kasshyap123/smart-robo/cad/rev_i_baseline/Rover_RevI_Assembly.step

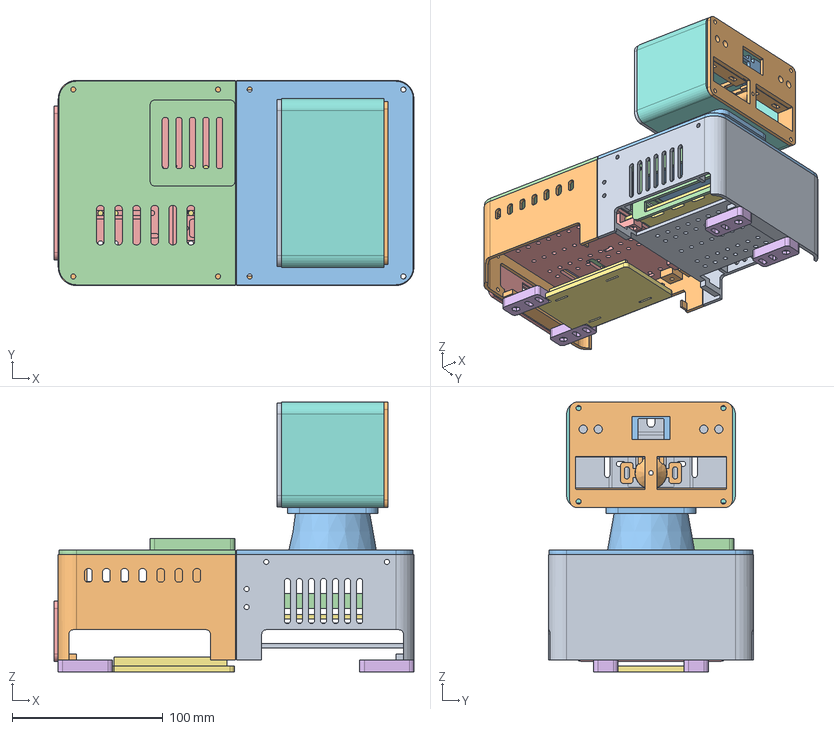
[picture p1: CAD file, 2026-10-26]
cad/rev_i_baseline/Rover_RevI_Assembly.step
238.8 x 136.0 x 179.0 mm
