kasshyap123/smart-robo/website/source-cad/rover_revF_CORRECTED_HOLD/cad/Rover_RevF_HOLD_Assembly.step

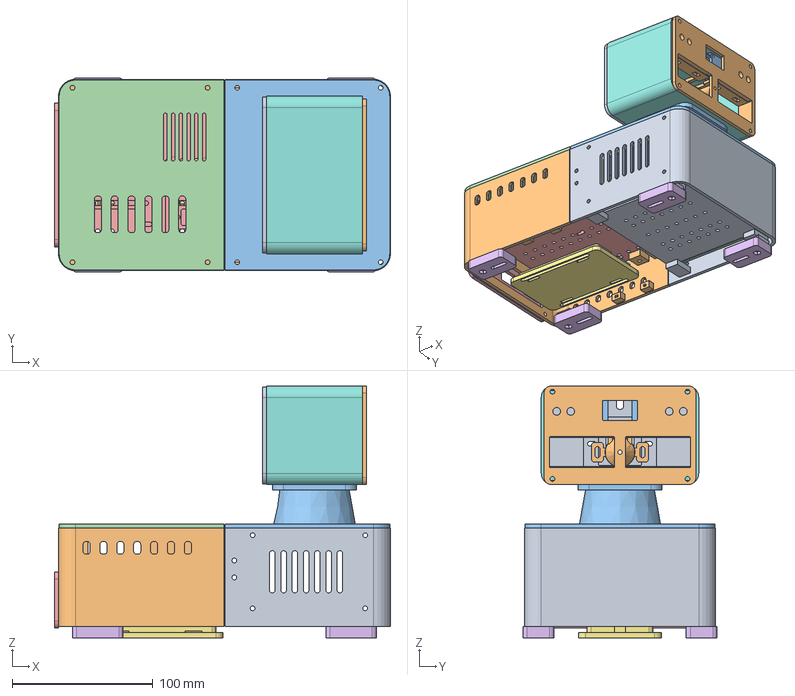
[picture p2: CAD file, 2026-10-26]
website/source-cad/rover_revF_CORRECTED_HOLD/cad/Rover_RevF_HOLD_Assembly.step
238.8 x 138.0 x 179.0 mm
