kasshyap123/smart-robo/cad/current_print_files/16_B13_2.stl

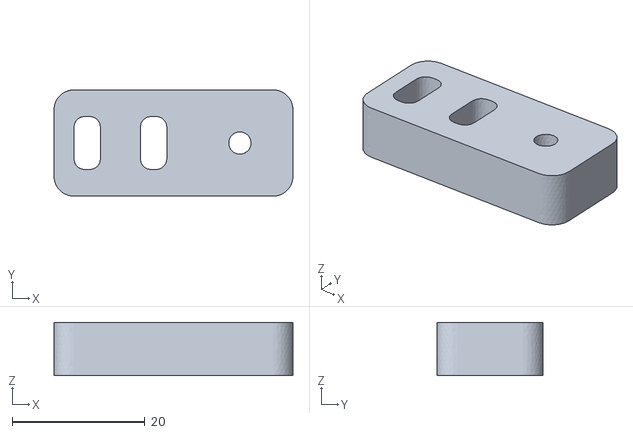
[picture p3: CAD file, 2026-10-26]
cad/current_print_files/16_B13_2.stl
36.0 x 16.0 x 8.00
