kasshyap123/smart-robo/cad/rev_i_baseline/master_step/B10R.step

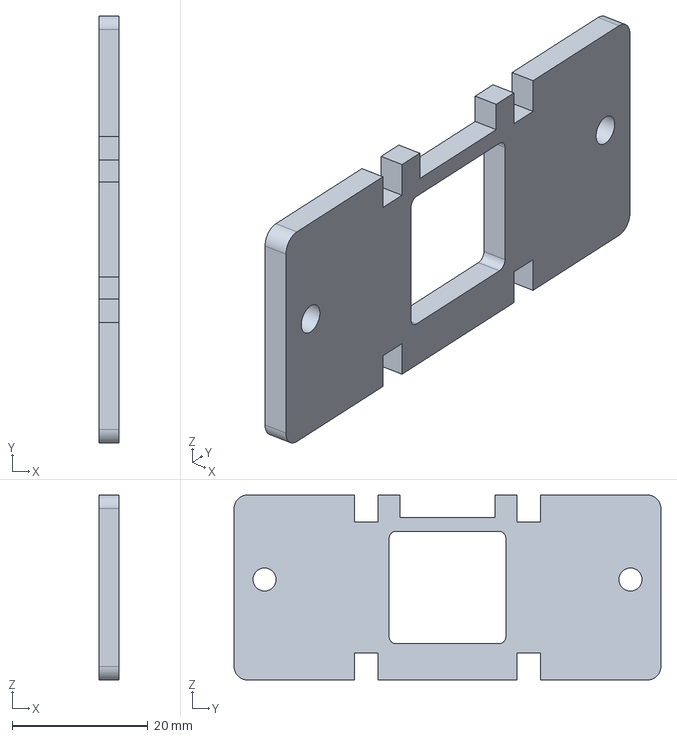
[picture p4: CAD file, 2026-10-26]
cad/rev_i_baseline/master_step/B10R.step
3.00 x 63.0 x 27.3 mm
