kasshyap123/smart-robo/cad/rev_i_baseline/positioned_step/B09.step

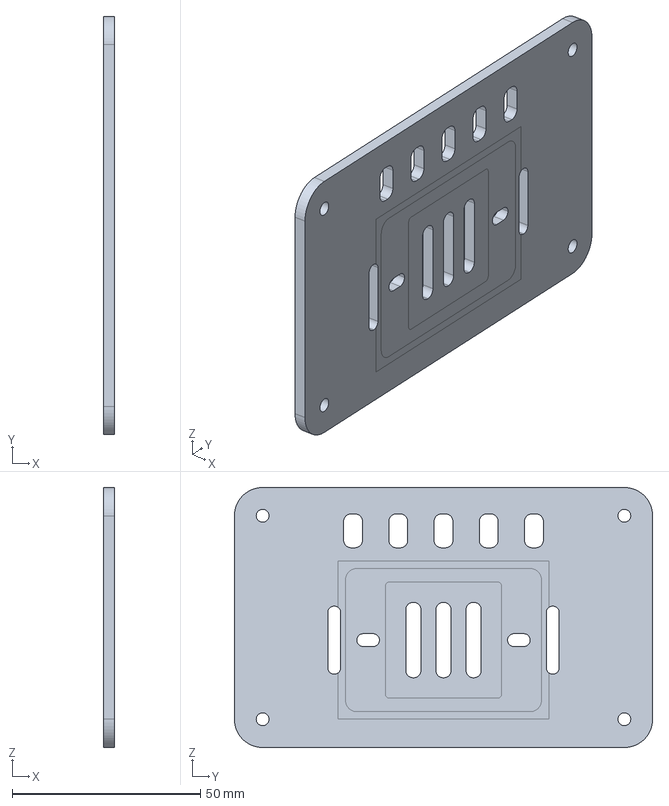
[picture p5: CAD file, 2026-10-26]
cad/rev_i_baseline/positioned_step/B09.step
3.00 x 111.0 x 69.0 mm
