kasshyap123/smart-robo/cad/rev_i_baseline/PRINT_ALL/14_B12.stl

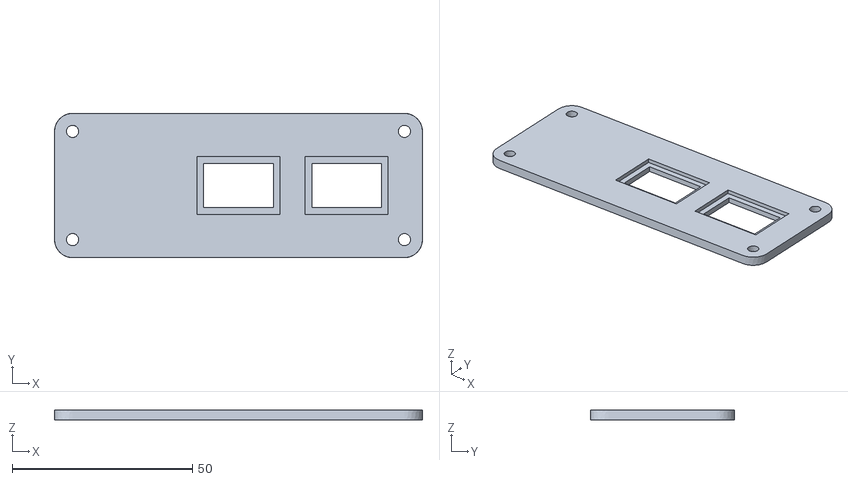
[picture p6: CAD file, 2026-10-26]
cad/rev_i_baseline/PRINT_ALL/14_B12.stl
102.0 x 40.0 x 2.80
