kasshyap123/smart-robo/website/source-cad/rover_revF_CORRECTED_HOLD/final_step/B01_final.step

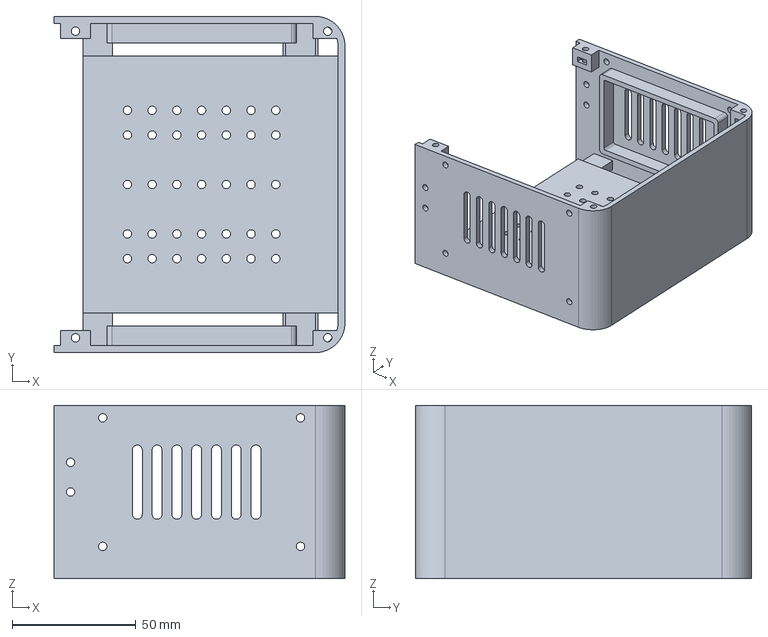
[picture p7: CAD file, 2026-10-26]
website/source-cad/rover_revF_CORRECTED_HOLD/final_step/B01_final.step
117.7 x 136.0 x 70.0 mm
