kasshyap123/smart-robo/website/source-cad/rover_revF_CORRECTED_HOLD/input_step/B11_final.step

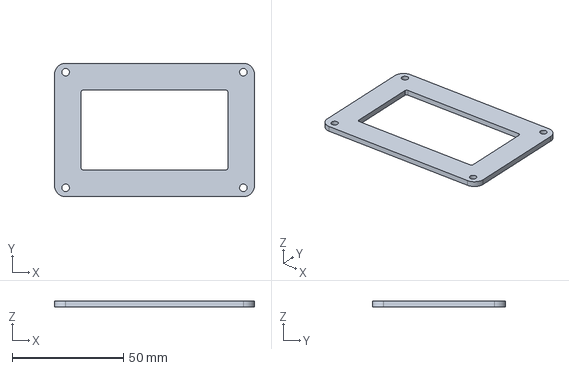
[picture p8: CAD file, 2026-10-26]
website/source-cad/rover_revF_CORRECTED_HOLD/input_step/B11_final.step
90.0 x 60.0 x 2.50 mm
