kasshyap123/smart-robo/website/source-cad/rover_revF_CORRECTED_HOLD/part_masters/B05_master.step

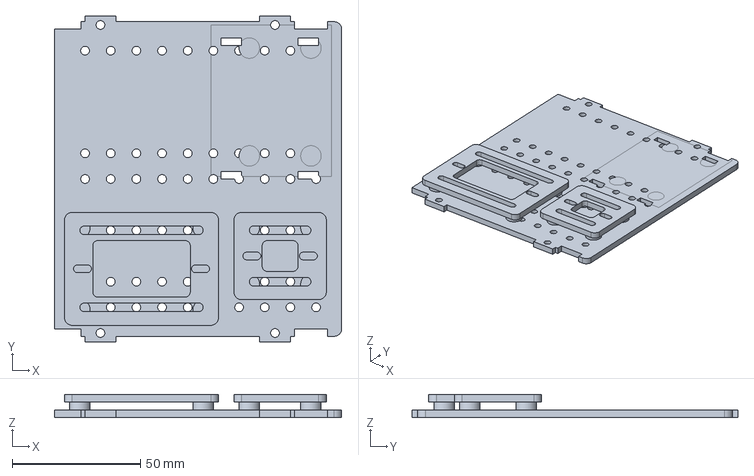
[picture p9: CAD file, 2026-10-26]
website/source-cad/rover_revF_CORRECTED_HOLD/part_masters/B05_master.step
112.0 x 127.0 x 9.00 mm
