kasshyap123/smart-robo/cad/current_print_files/03_B03.stl

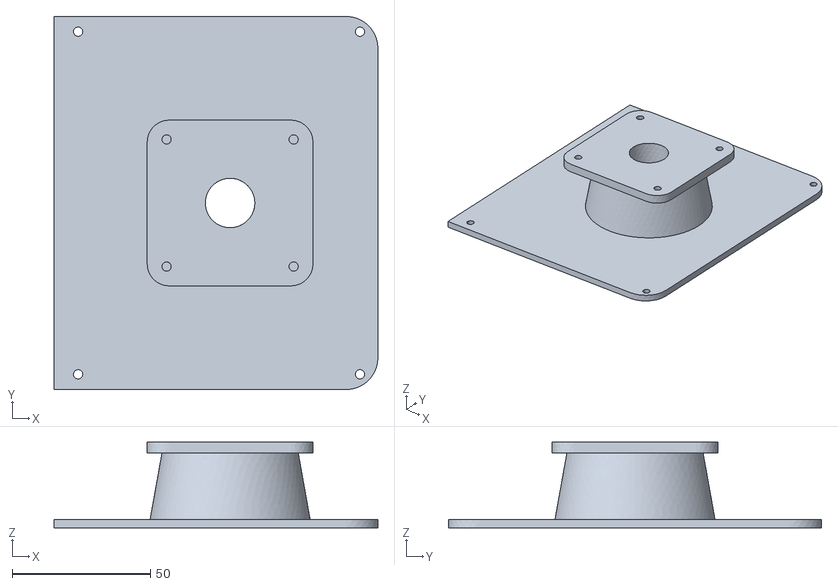
[picture p10: CAD file, 2026-10-26]
cad/current_print_files/03_B03.stl
117.2 x 135.0 x 31.0
