kasshyap123/smart-robo/cad/rev_i_baseline/input_step/B01.step

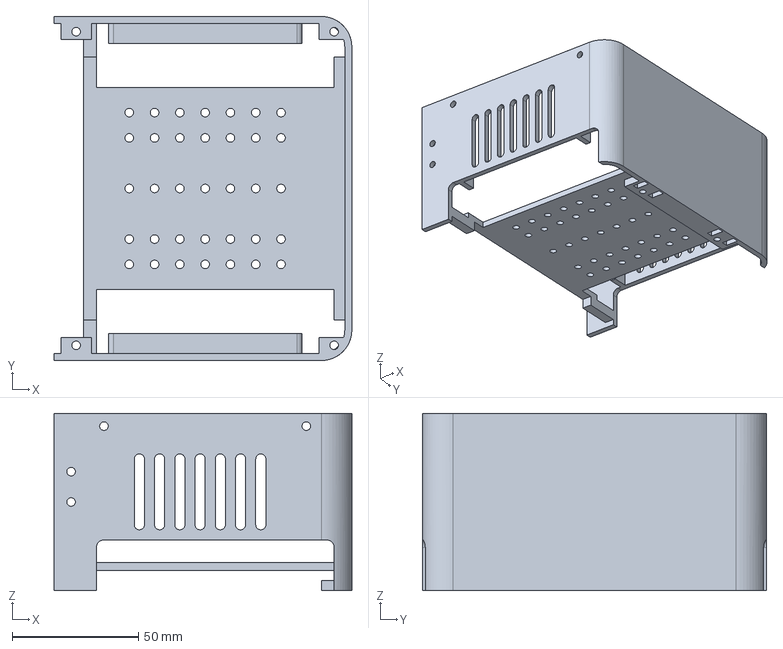
[picture p11: CAD file, 2026-10-26]
cad/rev_i_baseline/input_step/B01.step
117.7 x 136.0 x 70.0 mm
