kasshyap123/smart-robo/cad/rev_i_baseline/positioned_step/B06.step

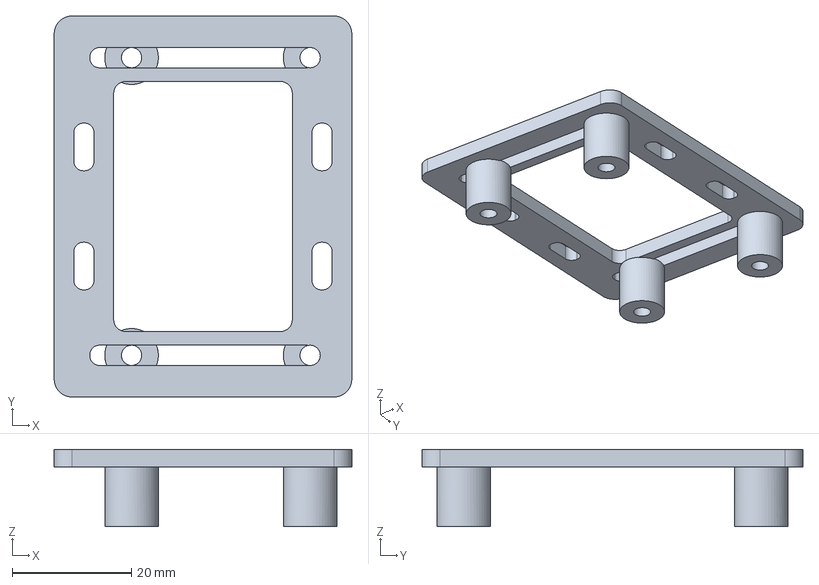
[picture p13: CAD file, 2026-10-26]
cad/rev_i_baseline/positioned_step/B06.step
50.0 x 64.0 x 13.0 mm
