kasshyap123/smart-robo/cad/rev_i_baseline/PRINT_ALL/13_B11_2.stl

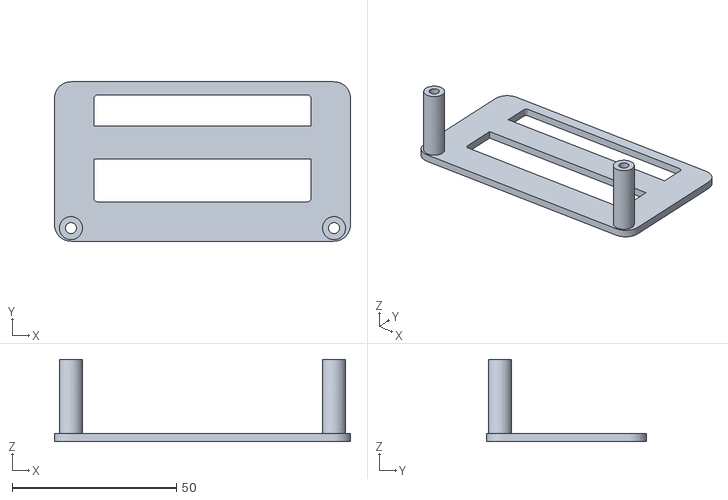
[picture p14: CAD file, 2026-10-26]
cad/rev_i_baseline/PRINT_ALL/13_B11_2.stl
90.0 x 48.5 x 25.0
