kasshyap123/smart-robo/website/source-cad/rover_revF_CORRECTED_HOLD/input_step/B10_final.step

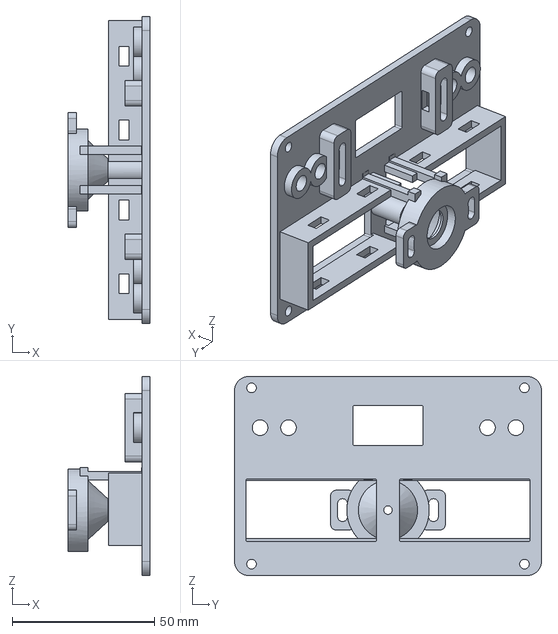
[picture p15: CAD file, 2026-10-26]
website/source-cad/rover_revF_CORRECTED_HOLD/input_step/B10_final.step
28.8 x 108.0 x 70.0 mm
