kasshyap123/smart-robo/cad/rev_i_baseline/master_step/B10.step

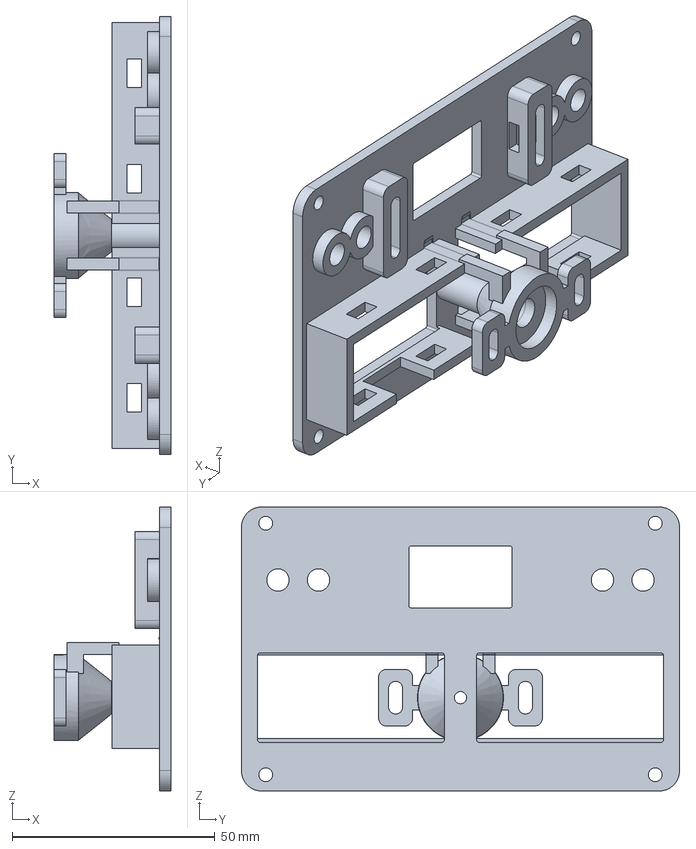
[picture p16: CAD file, 2026-10-26]
cad/rev_i_baseline/master_step/B10.step
28.8 x 108.0 x 70.0 mm
