kasshyap123/smart-robo/cad/rev_i_baseline/PRINT_ALL/07_B07.stl

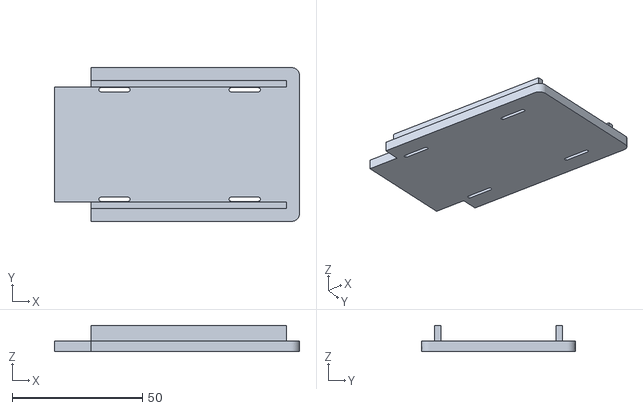
[picture p17: CAD file, 2026-10-26]
cad/rev_i_baseline/PRINT_ALL/07_B07.stl
94.0 x 59.0 x 10.0
