kasshyap123/smart-robo/website/source-cad/rover_revF_CORRECTED_HOLD/final_step/B04_final.step

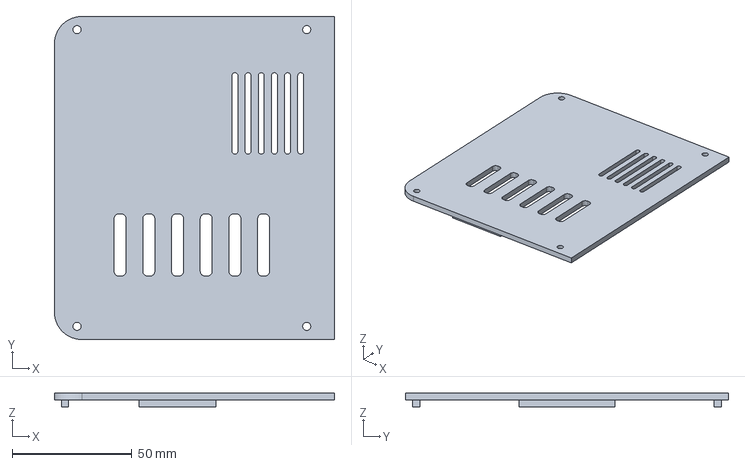
[picture p18: CAD file, 2026-10-26]
website/source-cad/rover_revF_CORRECTED_HOLD/final_step/B04_final.step
117.2 x 135.0 x 6.00 mm
