kasshyap123/smart-robo/website/source-cad/rover_revF_CORRECTED_HOLD/final_step/B06_final.step

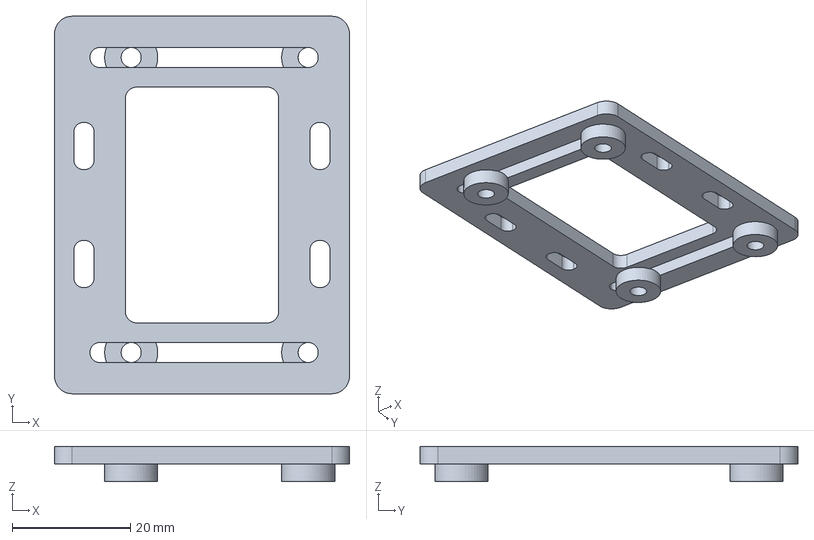
[picture p19: CAD file, 2026-10-26]
website/source-cad/rover_revF_CORRECTED_HOLD/final_step/B06_final.step
50.0 x 64.0 x 6.00 mm
