kasshyap123/smart-robo/cad/current_print_files/02_B02.stl

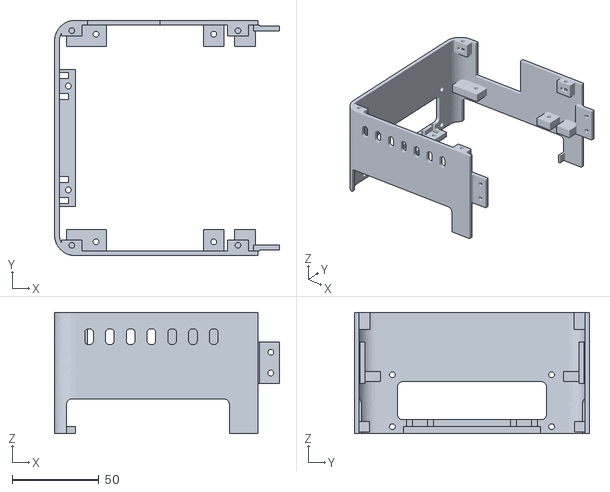
[picture p20: CAD file, 2026-10-26]
cad/current_print_files/02_B02.stl
130.0 x 136.0 x 70.0
