kasshyap123/smart-robo/cad/rev_i_baseline/PRINT_ALL/19_B14.stl

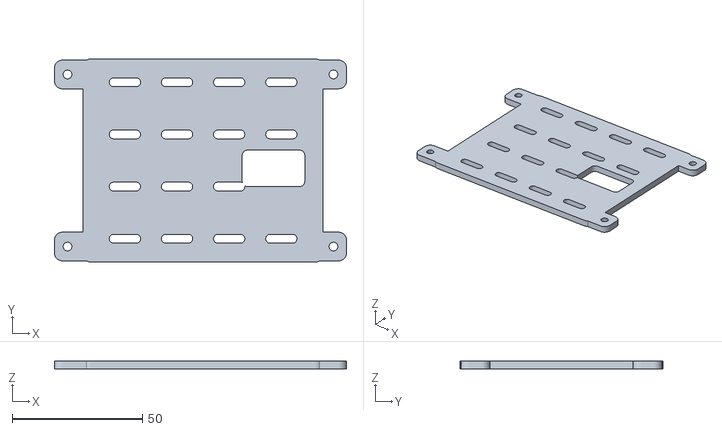
[picture p21: CAD file, 2026-10-26]
cad/rev_i_baseline/PRINT_ALL/19_B14.stl
112.0 x 78.0 x 3.00
