kasshyap123/smart-robo/website/source-cad/rover_revF_CORRECTED_HOLD/part_masters/B07_master.step

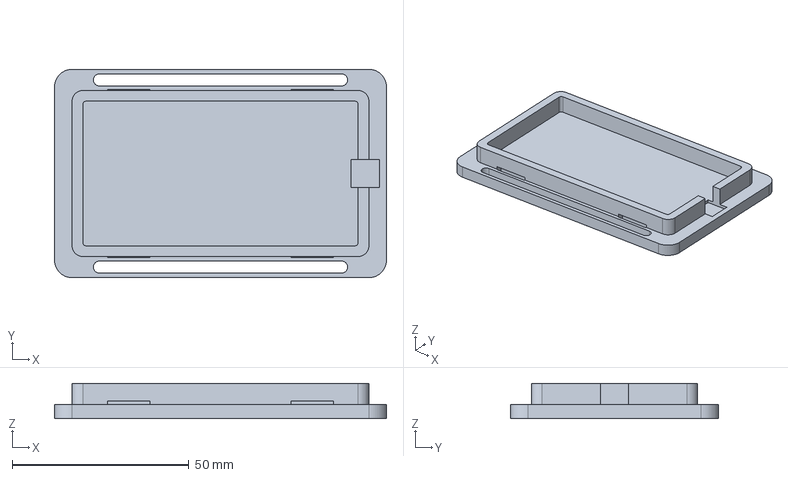
[picture p22: CAD file, 2026-10-26]
website/source-cad/rover_revF_CORRECTED_HOLD/part_masters/B07_master.step
94.0 x 59.0 x 10.0 mm
