kasshyap123/smart-robo/website/source-cad/rover_revF_CORRECTED_HOLD/final_step/B08_final.step

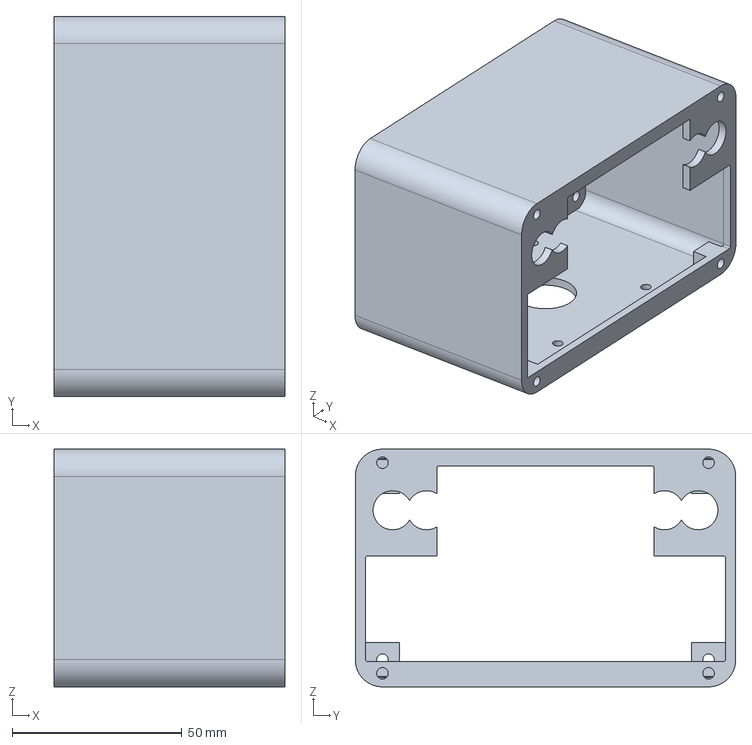
[picture p23: CAD file, 2026-10-26]
website/source-cad/rover_revF_CORRECTED_HOLD/final_step/B08_final.step
68.0 x 112.0 x 70.0 mm
