kasshyap123/smart-robo/website/source-cad/rover_revF_CORRECTED_HOLD/input_step/B02_final.step

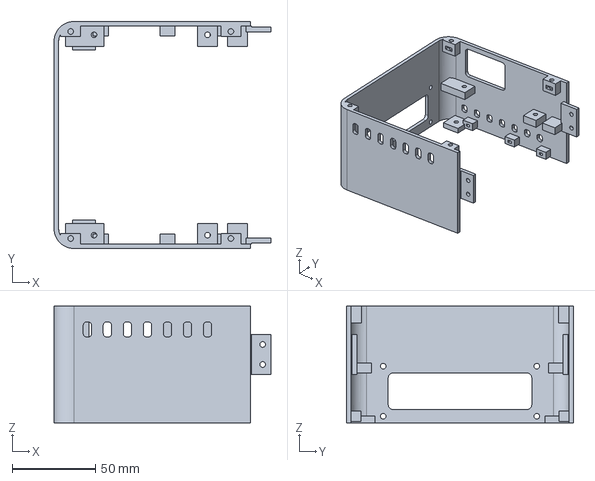
[picture p24: CAD file, 2026-10-26]
website/source-cad/rover_revF_CORRECTED_HOLD/input_step/B02_final.step
130.0 x 136.0 x 70.0 mm
