kasshyap123/smart-robo/website/source-cad/rover_revF_CORRECTED_HOLD/final_step/B13_front_right_final.step

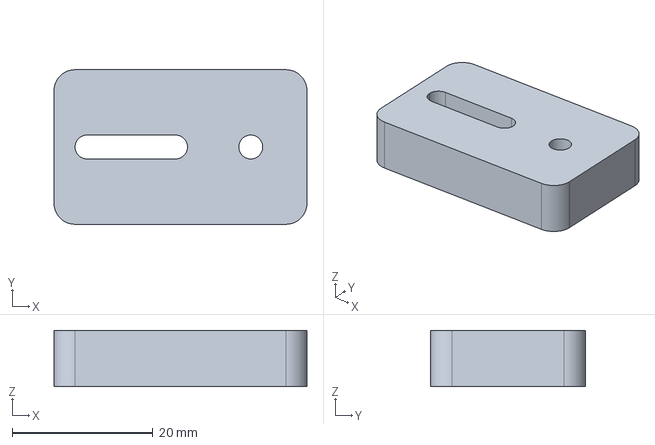
[picture p25: CAD file, 2026-10-26]
website/source-cad/rover_revF_CORRECTED_HOLD/final_step/B13_front_right_final.step
36.0 x 22.0 x 8.00 mm
