kasshyap123/smart-robo/cad/current_print_files/04_B04.stl

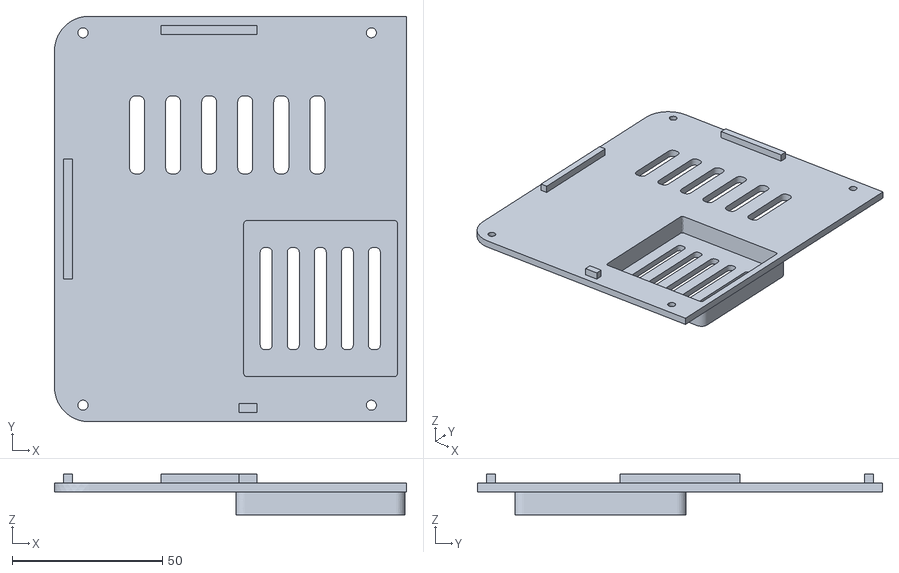
[picture p26: CAD file, 2026-10-26]
cad/current_print_files/04_B04.stl
117.2 x 135.0 x 13.5
