kasshyap123/smart-robo/website/source-cad/rover_revF_CORRECTED_HOLD/final_step/B09_final.step

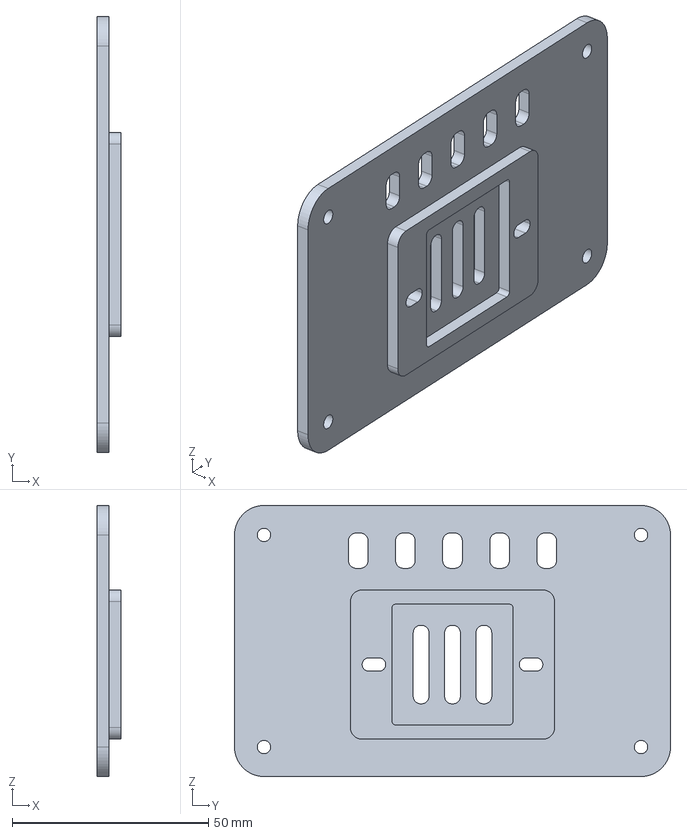
[picture p27: CAD file, 2026-10-26]
website/source-cad/rover_revF_CORRECTED_HOLD/final_step/B09_final.step
6.00 x 111.0 x 69.0 mm
