kasshyap123/smart-robo/cad/rev_i_baseline/master_step/B08.step

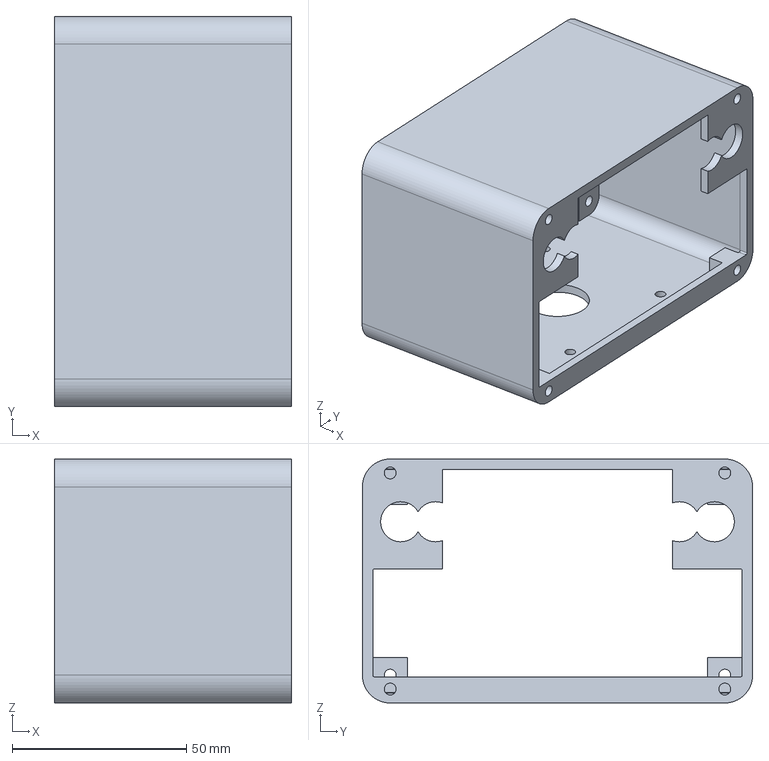
[picture p28: CAD file, 2026-10-26]
cad/rev_i_baseline/master_step/B08.step
68.0 x 112.0 x 70.0 mm
