kasshyap123/smart-robo/cad/rev_i_baseline/PRINT_ALL/05_B05.stl

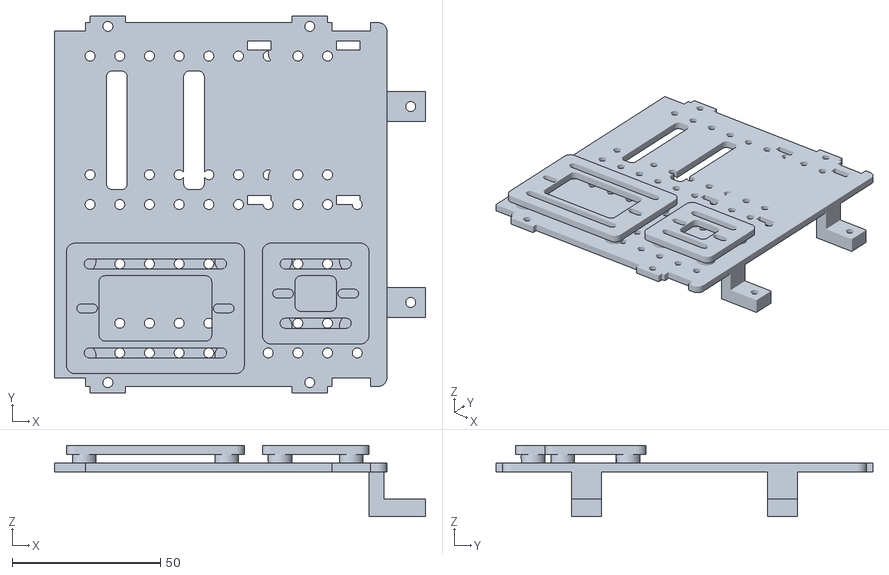
[picture p29: CAD file, 2026-10-26]
cad/rev_i_baseline/PRINT_ALL/05_B05.stl
125.0 x 127.0 x 24.0
