kasshyap123/smart-robo/cad/rev_i_baseline/input_step/B04.step

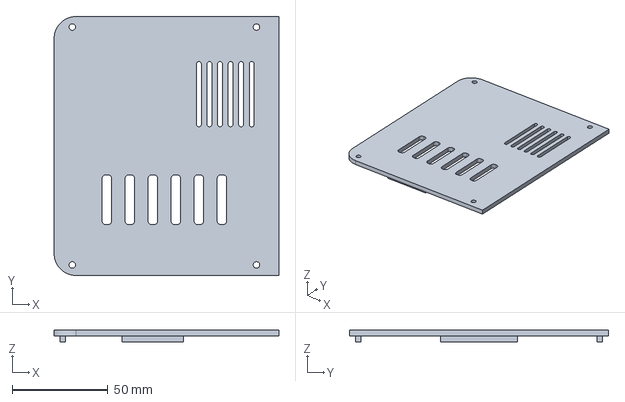
[picture p30: CAD file, 2026-10-26]
cad/rev_i_baseline/input_step/B04.step
117.2 x 135.0 x 6.00 mm
