kasshyap123/smart-robo/cad/current_print_files/14_B12_SWITCH_BODY_15x10_CORRECTED.stl

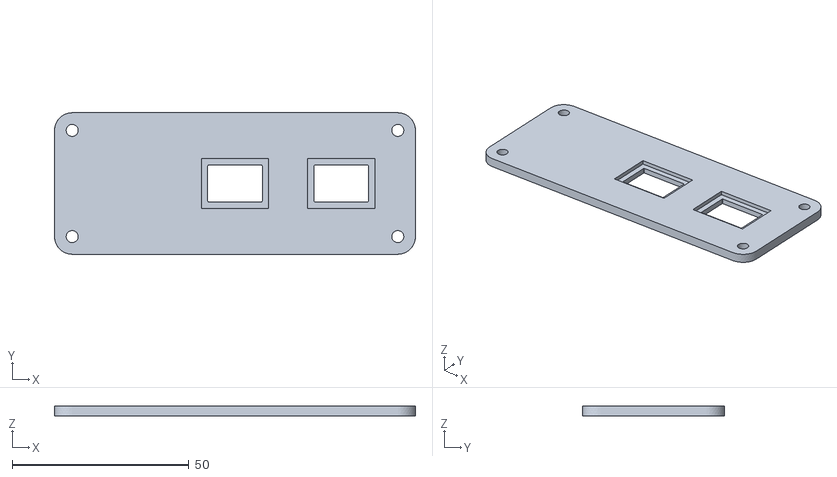
[picture p31: CAD file, 2026-10-26]
cad/current_print_files/14_B12_SWITCH_BODY_15x10_CORRECTED.stl
102.0 x 40.0 x 2.80
