kasshyap123/smart-robo/(list of files, cad)

Other CAD files:
cad/rev_i_baseline/input_step/B13.step
website/source-cad/rover_revF_CORRECTED_HOLD/final_step/B11_right_final.step
website/source-cad/rover_revF_CORRECTED_HOLD/part_masters/B01_master.step
cad/current_print_files/01_B01.stl
cad/rev_i_baseline/input_step/B12.step
cad/rev_i_baseline/positioned_step/B13_1.step
website/source-cad/rover_revF_CORRECTED_HOLD/input_step/B10R_final.step
website/source-cad/rover_revF_CORRECTED_HOLD/part_masters/B04_master.step
cad/rev_i_baseline/master_step/B06.step
cad/rev_i_baseline/positioned_step/B11_2.step
website/source-cad/rover_revF_CORRECTED_HOLD/part_masters/B06_master.step
cad/rev_i_baseline/master_step/B12.step
cad/rev_i_baseline/positioned_step/B12.step
website/source-cad/rover_revF_CORRECTED_HOLD/final_step/B10_final.step
website/source-cad/rover_revF_CORRECTED_HOLD/input_step/B04_final.step
cad/rev_i_baseline/input_step/B09.step
cad/rev_i_baseline/master_step/B13.step
cad/rev_i_baseline/positioned_step/B01.step
cad/rev_i_baseline/PRINT_ALL/10_B10.stl
website/source-cad/rover_revF_CORRECTED_HOLD/part_masters/B03_master.step
cad/rev_i_baseline/input_step/B07.step
cad/rev_i_baseline/master_step/B07.step
cad/rev_i_baseline/positioned_step/B14.step
website/source-cad/rover_revF_CORRECTED_HOLD/input_step/B01_final.step
website/source-cad/rover_revF_CORRECTED_HOLD/part_masters/B08_master.step
cad/rev_i_baseline/input_step/B14.step
cad/rev_i_baseline/master_step/B14.step
cad/rev_i_baseline/positioned_step/B10R.step
website/source-cad/rover_revF_CORRECTED_HOLD/input_step/B03_final.step
website/source-cad/rover_revF_CORRECTED_HOLD/part_masters/B13_master.step
cad/current_print_files/09_B09.stl
cad/rev_i_baseline/input_step/B06.step
cad/rev_i_baseline/master_step/B04.step
cad/rev_i_baseline/positioned_step/B11_1.step
website/source-cad/rover_revF_CORRECTED_HOLD/final_step/B03_final.step
website/source-cad/rover_revF_CORRECTED_HOLD/input_step/B13_final.step
website/source-cad/rover_revF_CORRECTED_HOLD/part_masters/B10_master.step
cad/current_print_files/11_B10R.stl
cad/rev_i_baseline/input_step/B11.step
cad/rev_i_baseline/positioned_step/B08.step
website/source-cad/rover_revF_CORRECTED_HOLD/final_step/B05_final.step
website/source-cad/rover_revF_CORRECTED_HOLD/input_step/B12_final.step
cad/rev_i_baseline/master_step/B09.step
cad/rev_i_baseline/positioned_step/B13_2.step
website/source-cad/rover_revF_CORRECTED_HOLD/final_step/B02_final.step
website/source-cad/rover_revF_CORRECTED_HOLD/input_step/B06_final.step
cad/current_print_files/08_B08.stl
cad/rev_i_baseline/input_step/B03.step
cad/rev_i_baseline/master_step/B11.step
cad/rev_i_baseline/positioned_step/B04.step
cad/rev_i_baseline/PRINT_ALL/11_B10R.stl
website/source-cad/rover_revF_CORRECTED_HOLD/final_step/B13_rear_right_final.step
website/source-cad/rover_revF_CORRECTED_HOLD/input_step/B09_final.step
website/source-cad/rover_revF_CORRECTED_HOLD/part_masters/B12_master.step
cad/rev_i_baseline/input_step/B02.step
cad/rev_i_baseline/master_step/B02.step
cad/rev_i_baseline/positioned_step/B05.step
cad/rev_i_baseline/PRINT_ALL/09_B09.stl
website/source-cad/rover_revF_CORRECTED_HOLD/final_step/B13_rear_left_final.step
website/source-cad/rover_revF_CORRECTED_HOLD/input_step/B08_final.step
website/source-cad/rover_revF_CORRECTED_HOLD/part_masters/B10R_master.step
cad/current_print_files/06_B06.stl
cad/rev_i_baseline/input_step/B05.step
cad/rev_i_baseline/master_step/B05.step
cad/rev_i_baseline/positioned_step/B07.step
cad/rev_i_baseline/PRINT_ALL/06_B06.stl
website/source-cad/rover_revF_CORRECTED_HOLD/final_step/B11_final.step
website/source-cad/rover_revF_CORRECTED_HOLD/part_masters/B09_master.step
cad/rev_i_baseline/master_step/B03.step
cad/rev_i_baseline/positioned_step/B13_3.step
cad/rev_i_baseline/PRINT_ALL/08_B08.stl
website/source-cad/rover_revF_CORRECTED_HOLD/final_step/B10R_final.step
cad/rev_i_baseline/positioned_step/B02.step
website/source-cad/rover_revF_CORRECTED_HOLD/final_step/B12_final.step
cad/rev_i_baseline/positioned_step/B03.step
website/source-cad/rover_revF_CORRECTED_HOLD/final_step/B13_final.step
cad/rev_i_baseline/positioned_step/B10.step
cad/rev_i_baseline/PRINT_ALL/01_B01.stl
website/source-cad/rover_revF_CORRECTED_HOLD/final_step/B07_final.step
cad/current_print_files/10_B10.stl
cad/rev_i_baseline/positioned_step/B13_4.step
